ZeddSerjeant/DCC/README.md

# DCC
This is a project built for a *Mechatronics* paper. It implements the core Digital Command Control (DCC) protocol in a transmitter and receiver. The circuits design and schematic is within the project, along with both sets of code, fully commented.
