ZeddSerjeant/DCC/report/img/index.md

# single_byte.jpg #

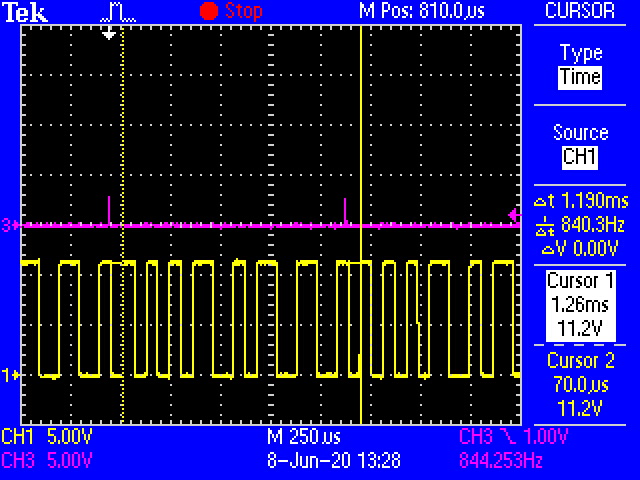
[picture p1: report/img/single_byte.JPG]
byte


This shows a single byte being output, following the DCC protocol.

The byte: `11101001`

# gate_level.jpg #

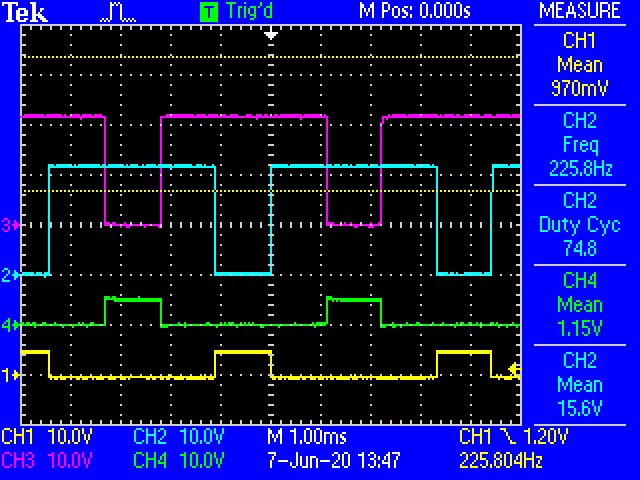
[picture p2: report/img/gate_level.JPG]
gate


This shows the the individual levels of the mosfet gates as the they toggle

# one.jpg #
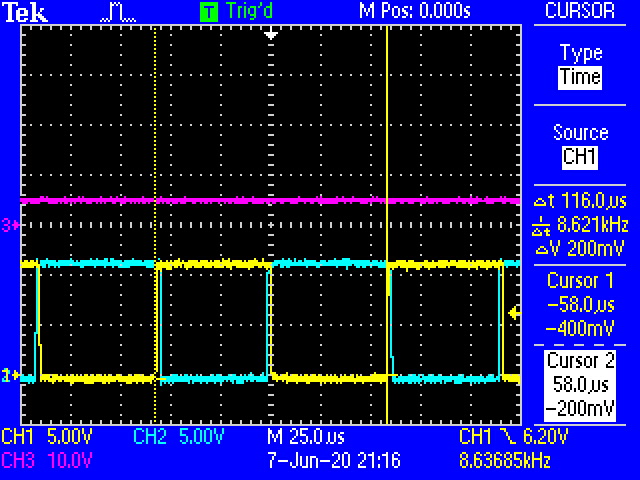
[picture p3: report/img/ONE.jpg]
one


a `one` bit

# zero.jpg #
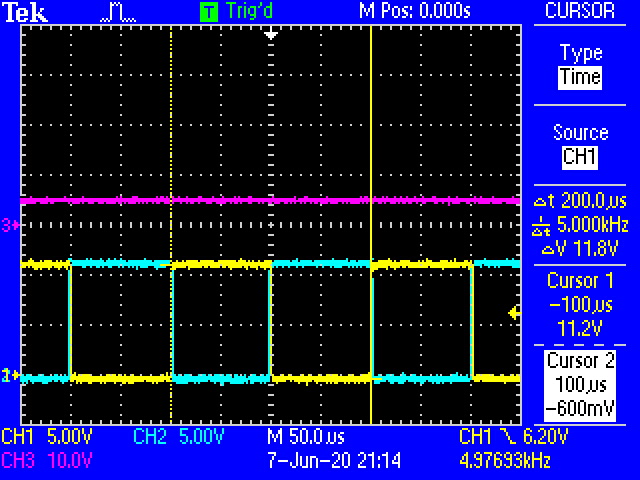
[picture p4: report/img/ZERO.jpg]
zero


a `zero` bit

# SHIFTTIME.jpg #
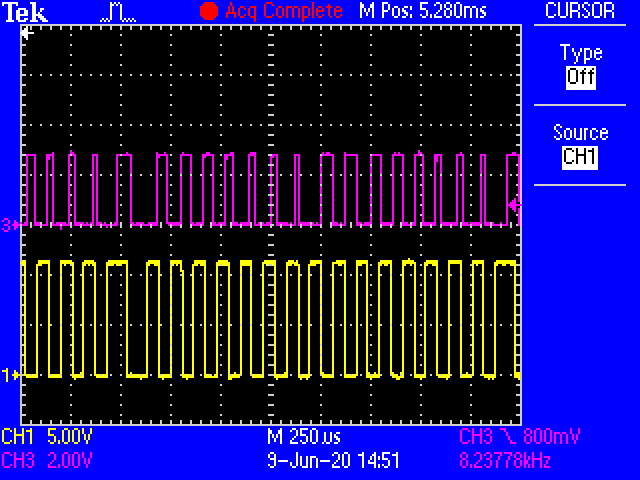
[picture p5: report/img/SHIFTTIME.jpg]


This shows the periodic delay from the shifts. This made errors pop up many times

# SHIFTTIME2.jpg #
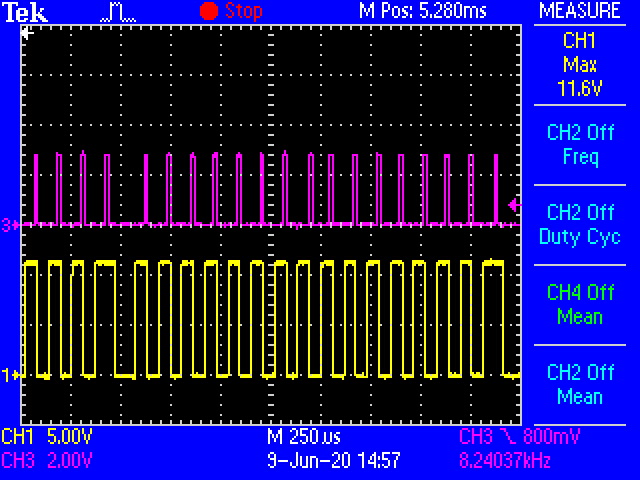
[picture p6: report/img/SHIFTTIME2.jpg]


This shows the state of affairs once I replaced the shift with mask array

# receiver_interrupt.JPG #
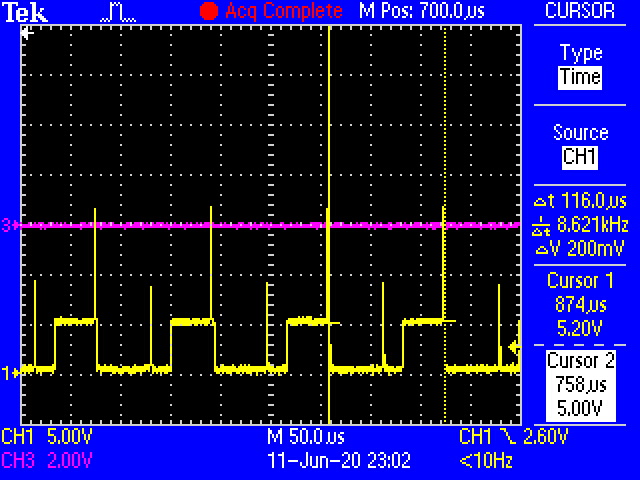
[picture p7: report/img/receiver_interrupt.JPG]


The time of the edge interrupt of the receiver. The cursor shows the period, it was receiving a stream of ones

# preamble.JPG #
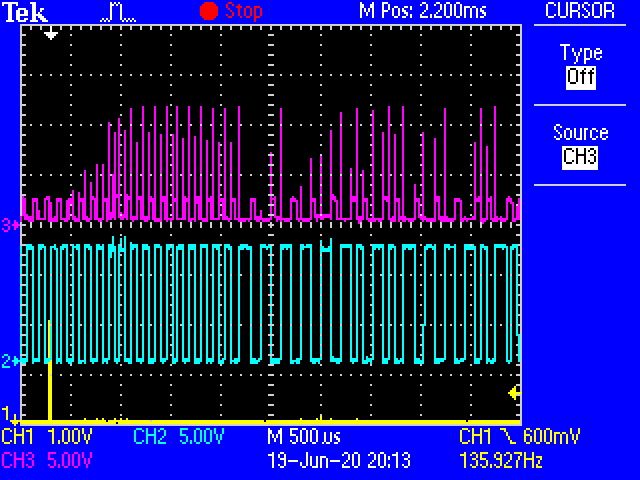
[picture p8: report/img/preamble.JPG]


Shows the preambe of a packet

# receiver_interrupt2(8MHz).JPG #
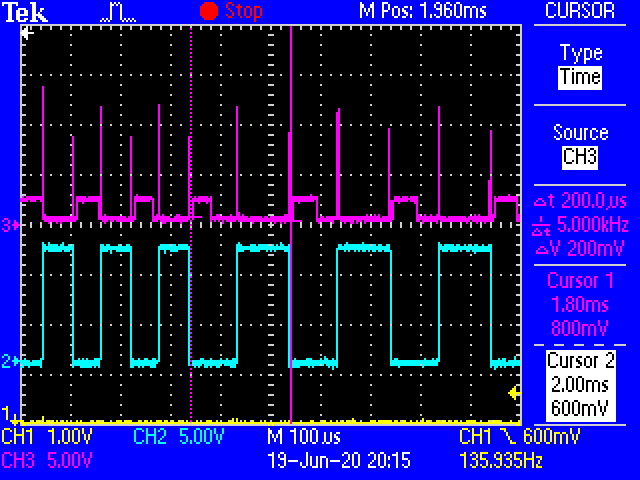
[picture p9: report/img/receiver_interrupt2(8MHz).JPG]


A better displayed reciever interrupt, running at 8MHz

# receiver_interrupt(4MHz).JPG #
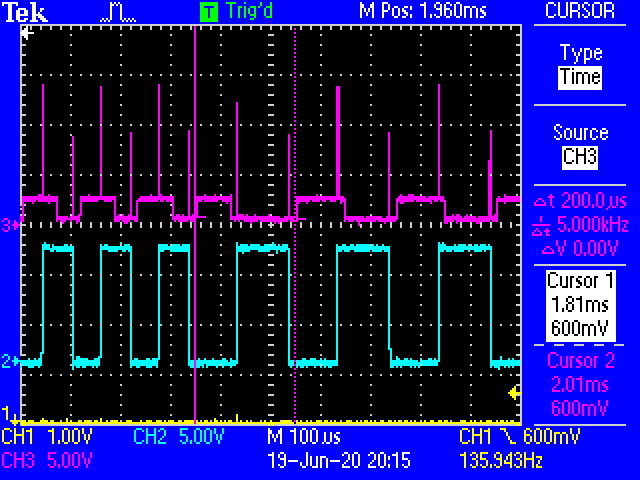
[picture p10: report/img/receiver_interrupt(4MHz).JPG]


receiver running at 4 MHz (via state button)

# FullPacket.JPG #
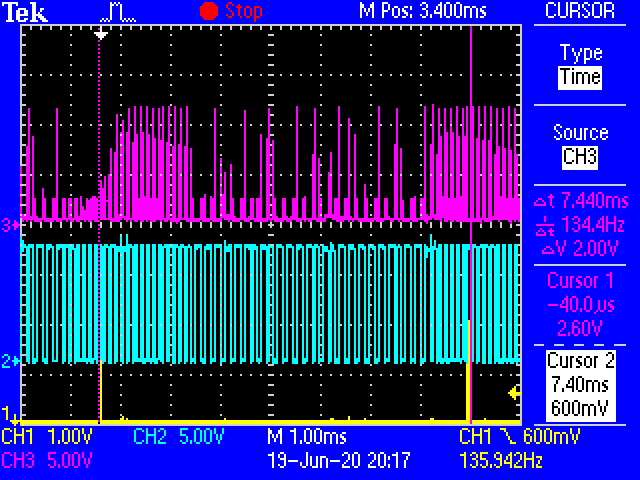
[picture p11: report/img/FullPacket.JPG]


A packet fully displayed

# transmitter_interrupt.JPG #
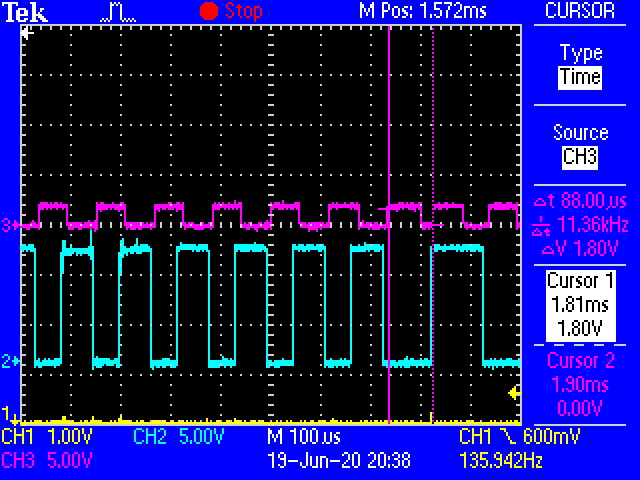
[picture p12: report/img/transmitter_interrupt.JPG]


Timing of transmit interrupt
