ZeddSerjeant/DCC/docs/Boot-strapped-H-bridge_bb.jpg

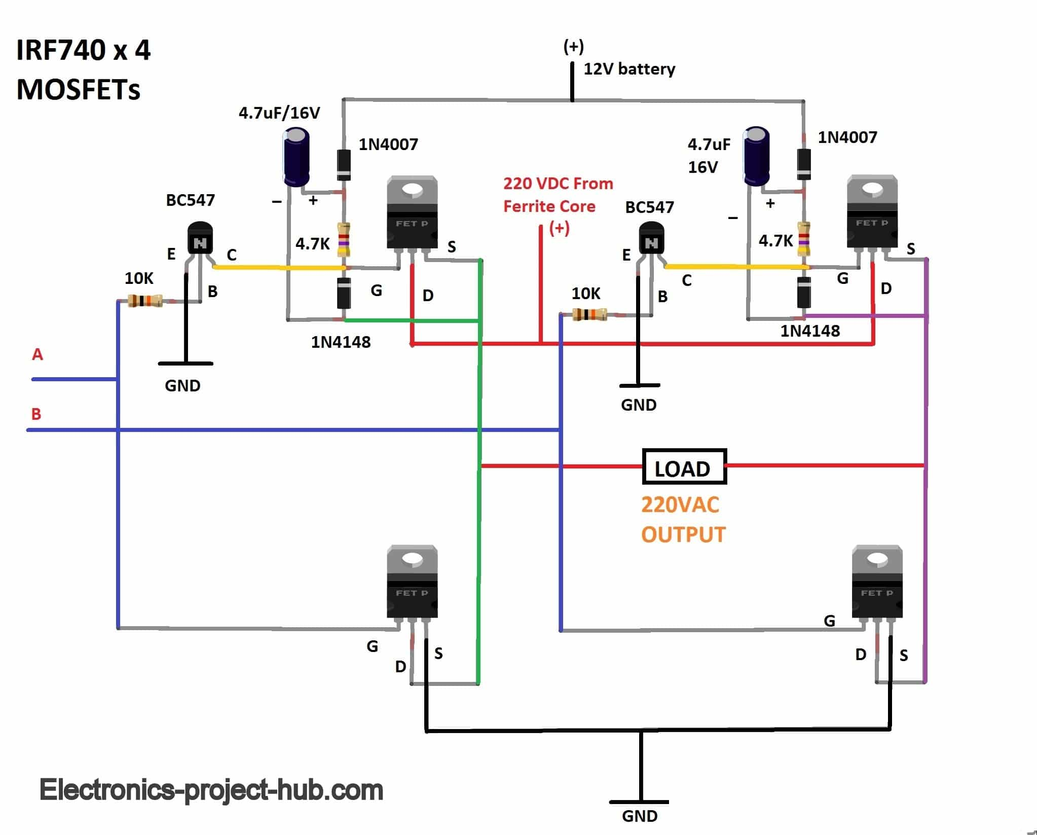
docs/Boot-strapped-H-bridge_bb.jpg
