ZeddSerjeant/DCC/report/img/DEADBAND.jpg

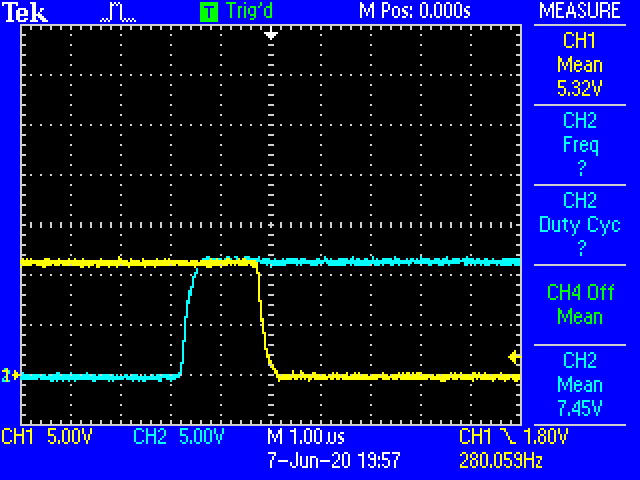
report/img/DEADBAND.jpg
