ZeddSerjeant/DCC/report/img/physical_boards.jpg

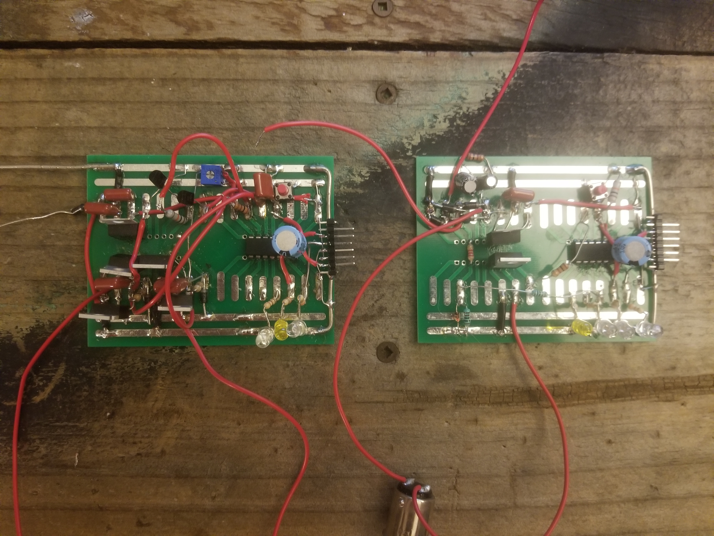
report/img/physical_boards.jpg
