ZeddSerjeant/DCC/report/img/uploded/receiver_interrupt2(8MHz).png

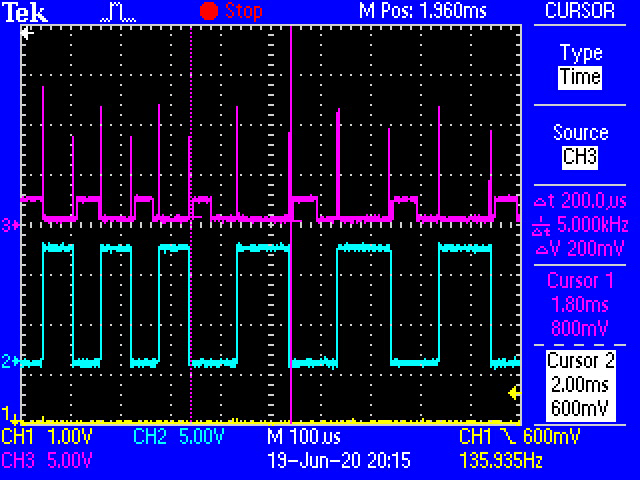
report/img/uploded/receiver_interrupt2(8MHz).png
