ZeddSerjeant/DCC/report/receiver_flowcart.png

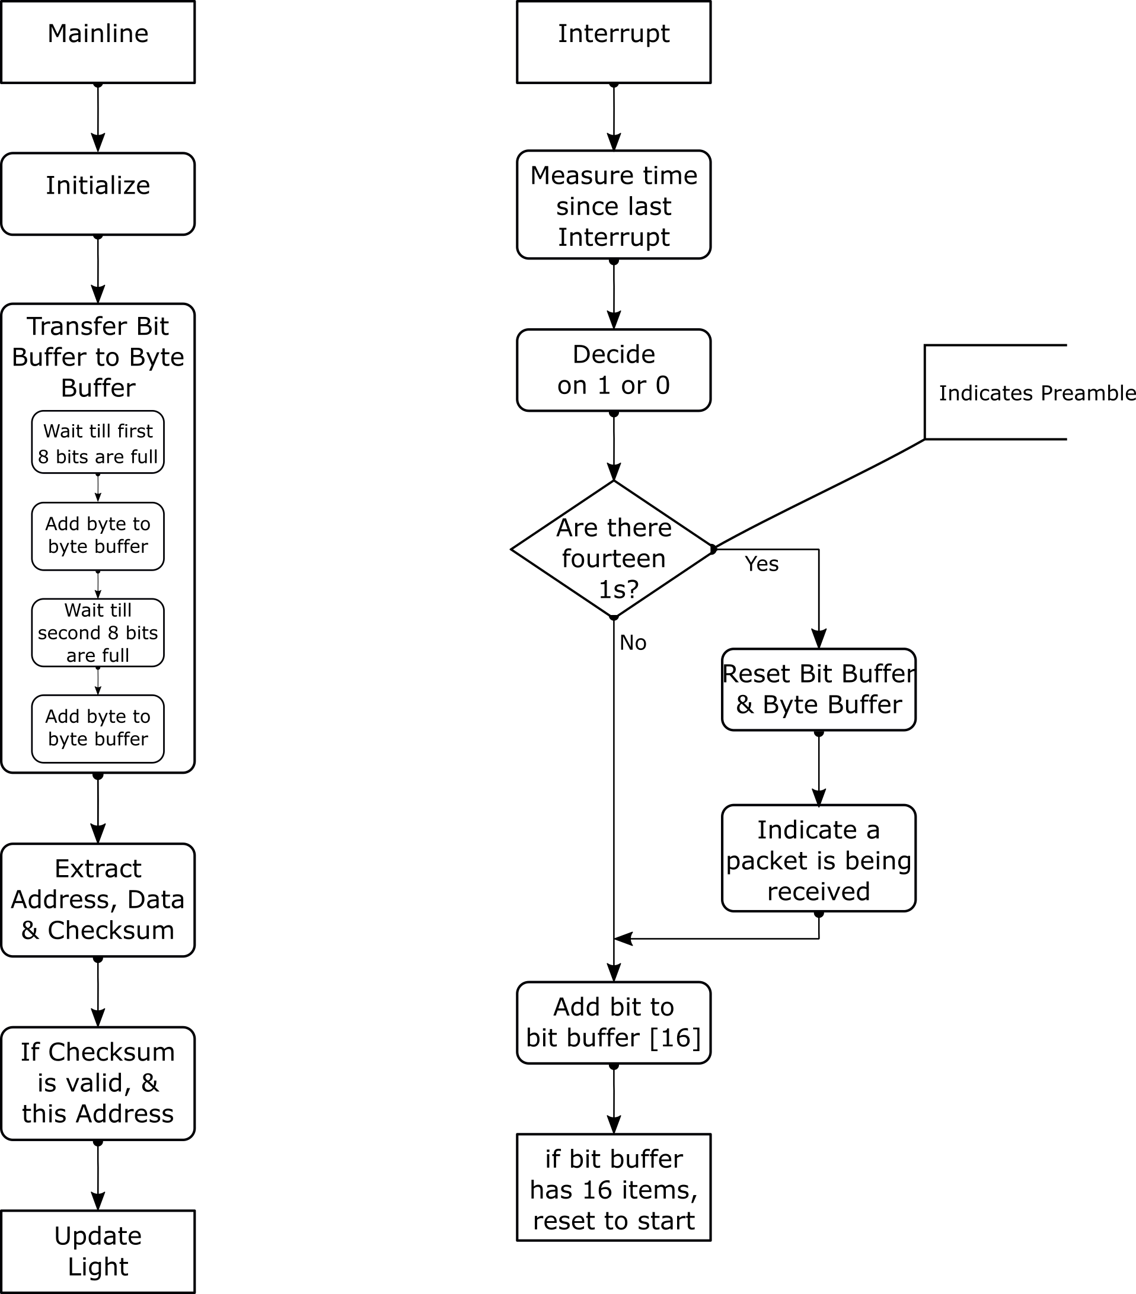
report/receiver_flowcart.png
