ZeddSerjeant/DCC/report/report/circuits/receiver.png

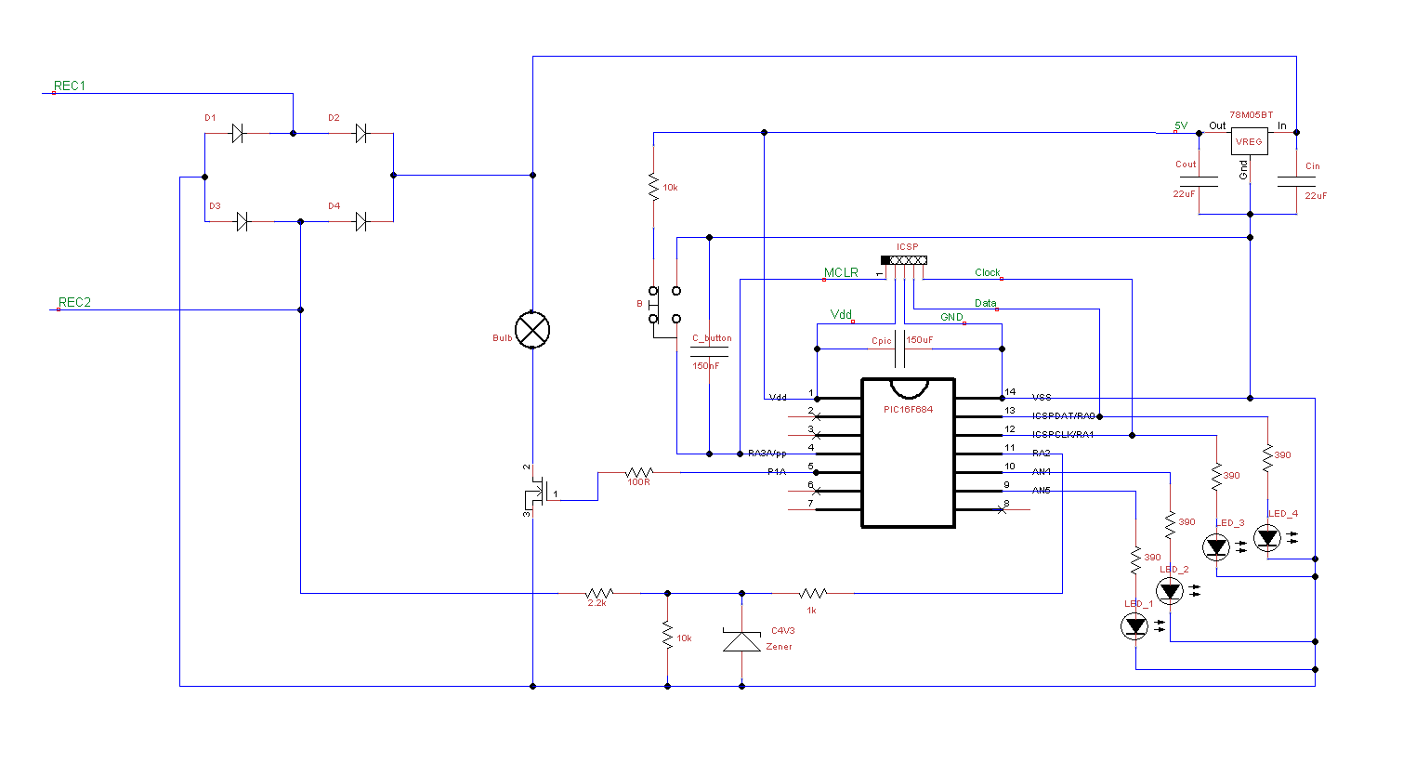
report/report/circuits/receiver.png
