ZeddSerjeant/DCC/report/report/circuits/transmitter.png

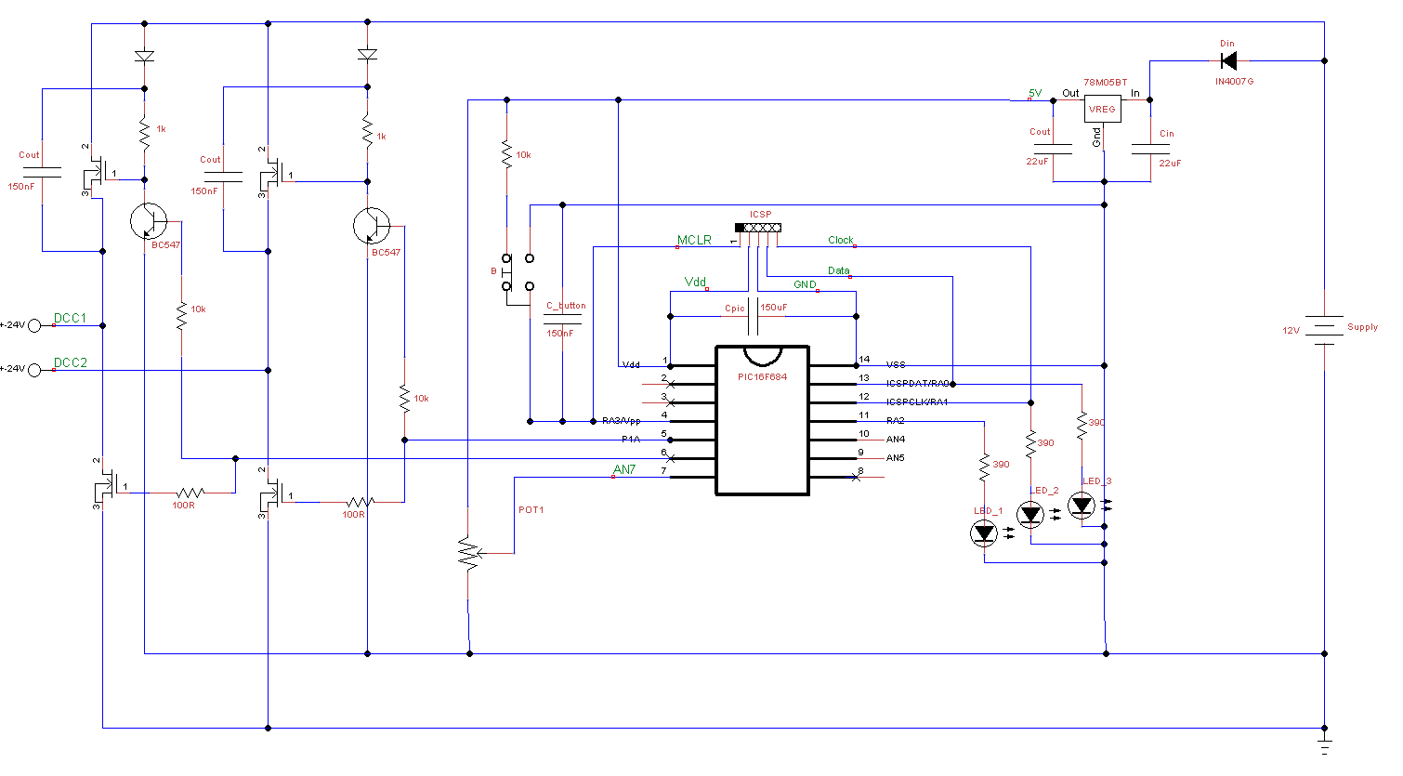
report/report/circuits/transmitter.png
