ZeddSerjeant/DCC/report/transmitter_flowcart.png

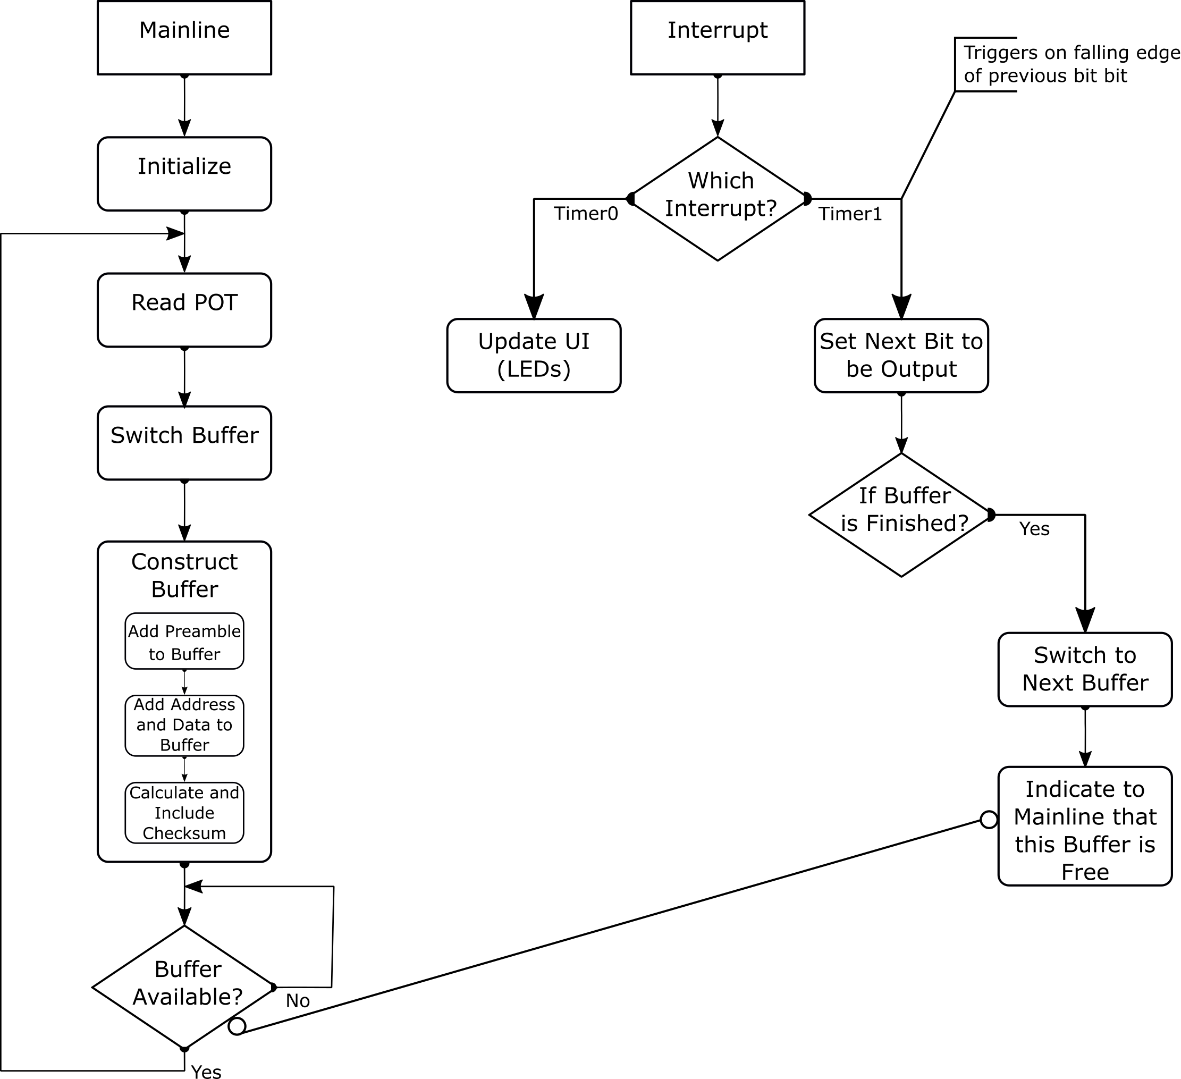
report/transmitter_flowcart.png
