ZeddSerjeant/DCC/(list of files, drawings)

Other design files:
hardware/receiver.dsn
hardware/transmitter.dsn
