ZeddSerjeant/DCC/(commit log)

2020-06-08 Added files. Basic single byte transmission following DCC electronic spec
    [transmitter.dsn]
2020-06-11 final commit for updating repo with trans/ceiver setup
    [receiver.dsn]
2020-06-14 Improvements in the "UI" (better LED output) more test states output from the transmit side
